chrishonson/openBMS/Docs/System-general-connections.pdf

# OpenBMS connection with CAN

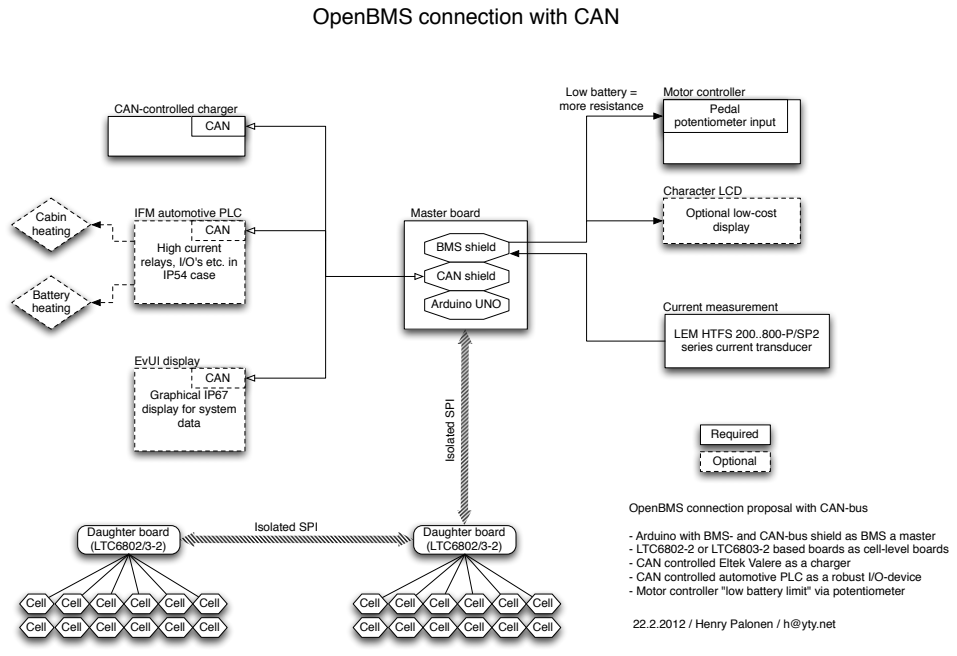
[picture p1: page 1]
Cell; Cell Cell Cell Cell Cell; Daughter board (LTC6802/3-2); BMS shield; CAN shield; Arduino UNO; CAN; Cabin heating; Battery heating; Motor controller Pedal potentiometer input; Current measurement; data; EvUI display; Character LCD; Required; Optional

Low battery =
more resistance
Master board Isolated SPI

CAN-controlled charger

IFM automotive PLC

Optional low-cost
display

High current
relays, I/O's etc. in
IP54 case

LEM HTFS 200..800-P/SP2
series current transducer

Graphical IP67
display for system

OpenBMS connection proposal with CAN-bus

Isolated SPI Daughter board
(LTC6802/3-2)

- Arduino with BMS- and CAN-bus shield as BMS a master
- LTC6802-2 or LTC6803-2 based boards as cell-level boards
- CAN controlled Eltek Valere as a charger
- CAN controlled automotive PLC as a robust I/O-device
- Motor controller "low battery limit" via potentiometer

22.2.2012 / Henry Palonen / h@yty.net
