chrishonson/openBMS/PCB_Design/daughter_board/bms3_1.brd

## EAGLE design PCB_Design/daughter_board/bms3_1.brd (2012-10-20)

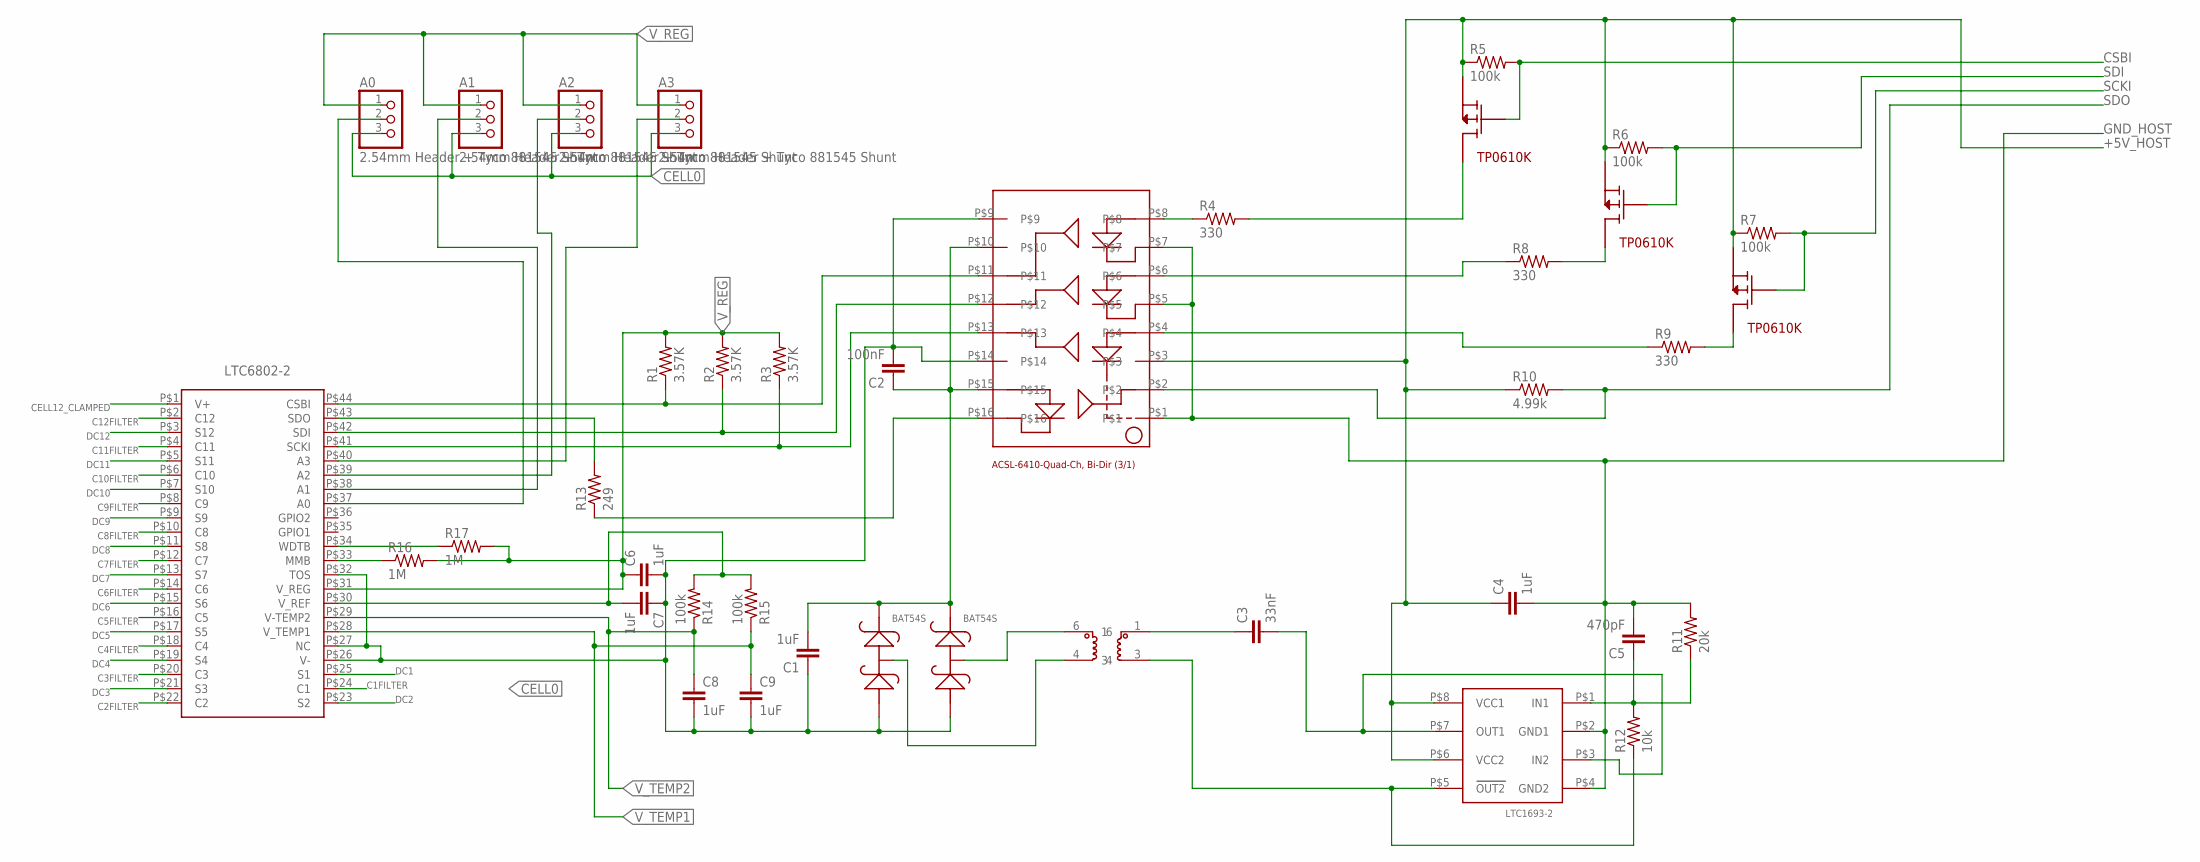
[picture p2: schematic bms3_1.sch, sheet 1]

Parts:
A0, A1, A2, A3: 2.54mm Header + Tyco 881545 Shunt; 1X03
ACSL6410: ACSL-6410; ACSL-6410-SO16
BAT1, BAT2: BAT54S; SOT-23
C1, C4, C6, C7, C8, C9: 1uF; C0603
C2: 100nF; C0603
C3: 33nF; C0603
C5: 470pF; C0603
CSBI: TP0610K; SOT-23
LTC1693: LTC1693-2; S8-LTC1693-2
PE68386: PE68386
R1, R2, R3: 3.57K; R0603
R4, R8, R9: 330; R0603
R5, R6, R7, R14, R15: 100k; R0603
R10: 4.99k; R0603
R11: 20k; R0603
R12: 10k; R0603
R13: 249; R0603
R16, R17: 1M; R0603
SCKI: TP0610K; SOT-23
SDI: TP0610K; SOT-23
X-BMS: LTC6802-2; SSOP-44

Connections:
+5V_HOST: ACSL6410.P$3, C4.1, CSBI.2, LTC1693.P$6 (VCC2), LTC1693.P$8 (VCC1), R5.1, R6.1, R7.1, R10.1, SCKI.2, SDI.2; also elsewhere on the board
C1FILTER: X-BMS.P$24 (C1); also elsewhere on the board
C2FILTER: X-BMS.P$22 (C2); also elsewhere on the board
C3FILTER: X-BMS.P$20 (C3); also elsewhere on the board
C4FILTER: X-BMS.P$18 (C4); also elsewhere on the board
C5FILTER: X-BMS.P$16 (C5); also elsewhere on the board
C6FILTER: X-BMS.P$14 (C6); also elsewhere on the board
C7FILTER: X-BMS.P$12 (C7); also elsewhere on the board
C8FILTER: X-BMS.P$10 (C8); also elsewhere on the board
C9FILTER: X-BMS.P$8 (C9); also elsewhere on the board
C10FILTER: X-BMS.P$6 (C10); also elsewhere on the board
C11FILTER: X-BMS.P$4 (C11); also elsewhere on the board
C12FILTER: X-BMS.P$2 (C12); also elsewhere on the board
CELL0: A0.3, A1.3, A2.3, A3.3, ACSL6410.P$9, ACSL6410.P$14, BAT1.1, BAT2.1, C1.1, C2.2, C6.2, C7.1, C8.2, C9.2, X-BMS.P$26 (V-), X-BMS.P$27 (NC), X-BMS.P$32 (TOS); also elsewhere on the board
CELL12_CLAMPED: X-BMS.P$1 (V+); also elsewhere on the board
CSBI: CSBI.1, R5.2; also elsewhere on the board
DC1: X-BMS.P$25 (S1); also elsewhere on the board
DC2: X-BMS.P$23 (S2); also elsewhere on the board
DC3: X-BMS.P$21 (S3); also elsewhere on the board
DC4: X-BMS.P$19 (S4); also elsewhere on the board
DC5: X-BMS.P$17 (S5); also elsewhere on the board
DC6: X-BMS.P$15 (S6); also elsewhere on the board
DC7: X-BMS.P$13 (S7); also elsewhere on the board
DC8: X-BMS.P$11 (S8); also elsewhere on the board
DC9: X-BMS.P$9 (S9); also elsewhere on the board
DC10: X-BMS.P$7 (S10); also elsewhere on the board
DC11: X-BMS.P$5 (S11); also elsewhere on the board
DC12: X-BMS.P$3 (S12); also elsewhere on the board
GND_HOST: ACSL6410.P$1, ACSL6410.P$5, ACSL6410.P$7, C4.2, C5.2, LTC1693.P$2 (GND1), LTC1693.P$4 (GND2), R11.2; also elsewhere on the board
unnamed: ACSL6410.P$11, R1.1, X-BMS.P$44 (CSBI)
unnamed: A3.2, X-BMS.P$40 (A3)
unnamed: ACSL6410.P$12, R2.1, X-BMS.P$42 (SDI)
unnamed: ACSL6410.P$13, R3.1, X-BMS.P$41 (SCKI)
unnamed: A2.2, X-BMS.P$39 (A2)
unnamed: A1.2, X-BMS.P$38 (A1)
unnamed: ACSL6410.P$16, R13.1
unnamed: R13.2, X-BMS.P$43 (SDO)
unnamed: BAT2.3, PE68386.6
unnamed: BAT1.3, PE68386.4
unnamed: R8.2, SDI.3
unnamed: C3.1, PE68386.1
unnamed: LTC1693.P$5 (OUT2), PE68386.3, R12.1
unnamed: C3.2, LTC1693.P$3 (IN2), LTC1693.P$7 (OUT1)
unnamed: A0.2, X-BMS.P$37 (A0)
unnamed: ACSL6410.P$6, R8.1
unnamed: C5.1, LTC1693.P$1 (IN1), R11.1, R12.2
unnamed: R9.2, SCKI.3
unnamed: ACSL6410.P$4, R9.1
unnamed: R17.1, X-BMS.P$34 (WDTB)
unnamed: R16.1, X-BMS.P$33 (MMB)
unnamed: ACSL6410.P$8, R4.1
unnamed: CSBI.3, R4.2
unnamed: ACSL6410.P$10, ACSL6410.P$15, BAT1.2, BAT2.2, C1.2, C2.1
SCKI: R7.2, SCKI.1; also elsewhere on the board
SDI: R6.2, SDI.1; also elsewhere on the board
SDO: ACSL6410.P$2, R10.2; also elsewhere on the board
V_REF: C7.2, R14.2, R15.2, X-BMS.P$30 (V_REF)
V_REG: A0.1, A1.1, A2.1, A3.1, C6.1, R1.2, R2.2, R3.2, R16.2, R17.2, X-BMS.P$31 (V_REG)
V_TEMP1: C9.1, R15.1, X-BMS.P$28 (V_TEMP1); also elsewhere on the board
V_TEMP2: C8.1, R14.1, X-BMS.P$29 (V-TEMP2); also elsewhere on the board

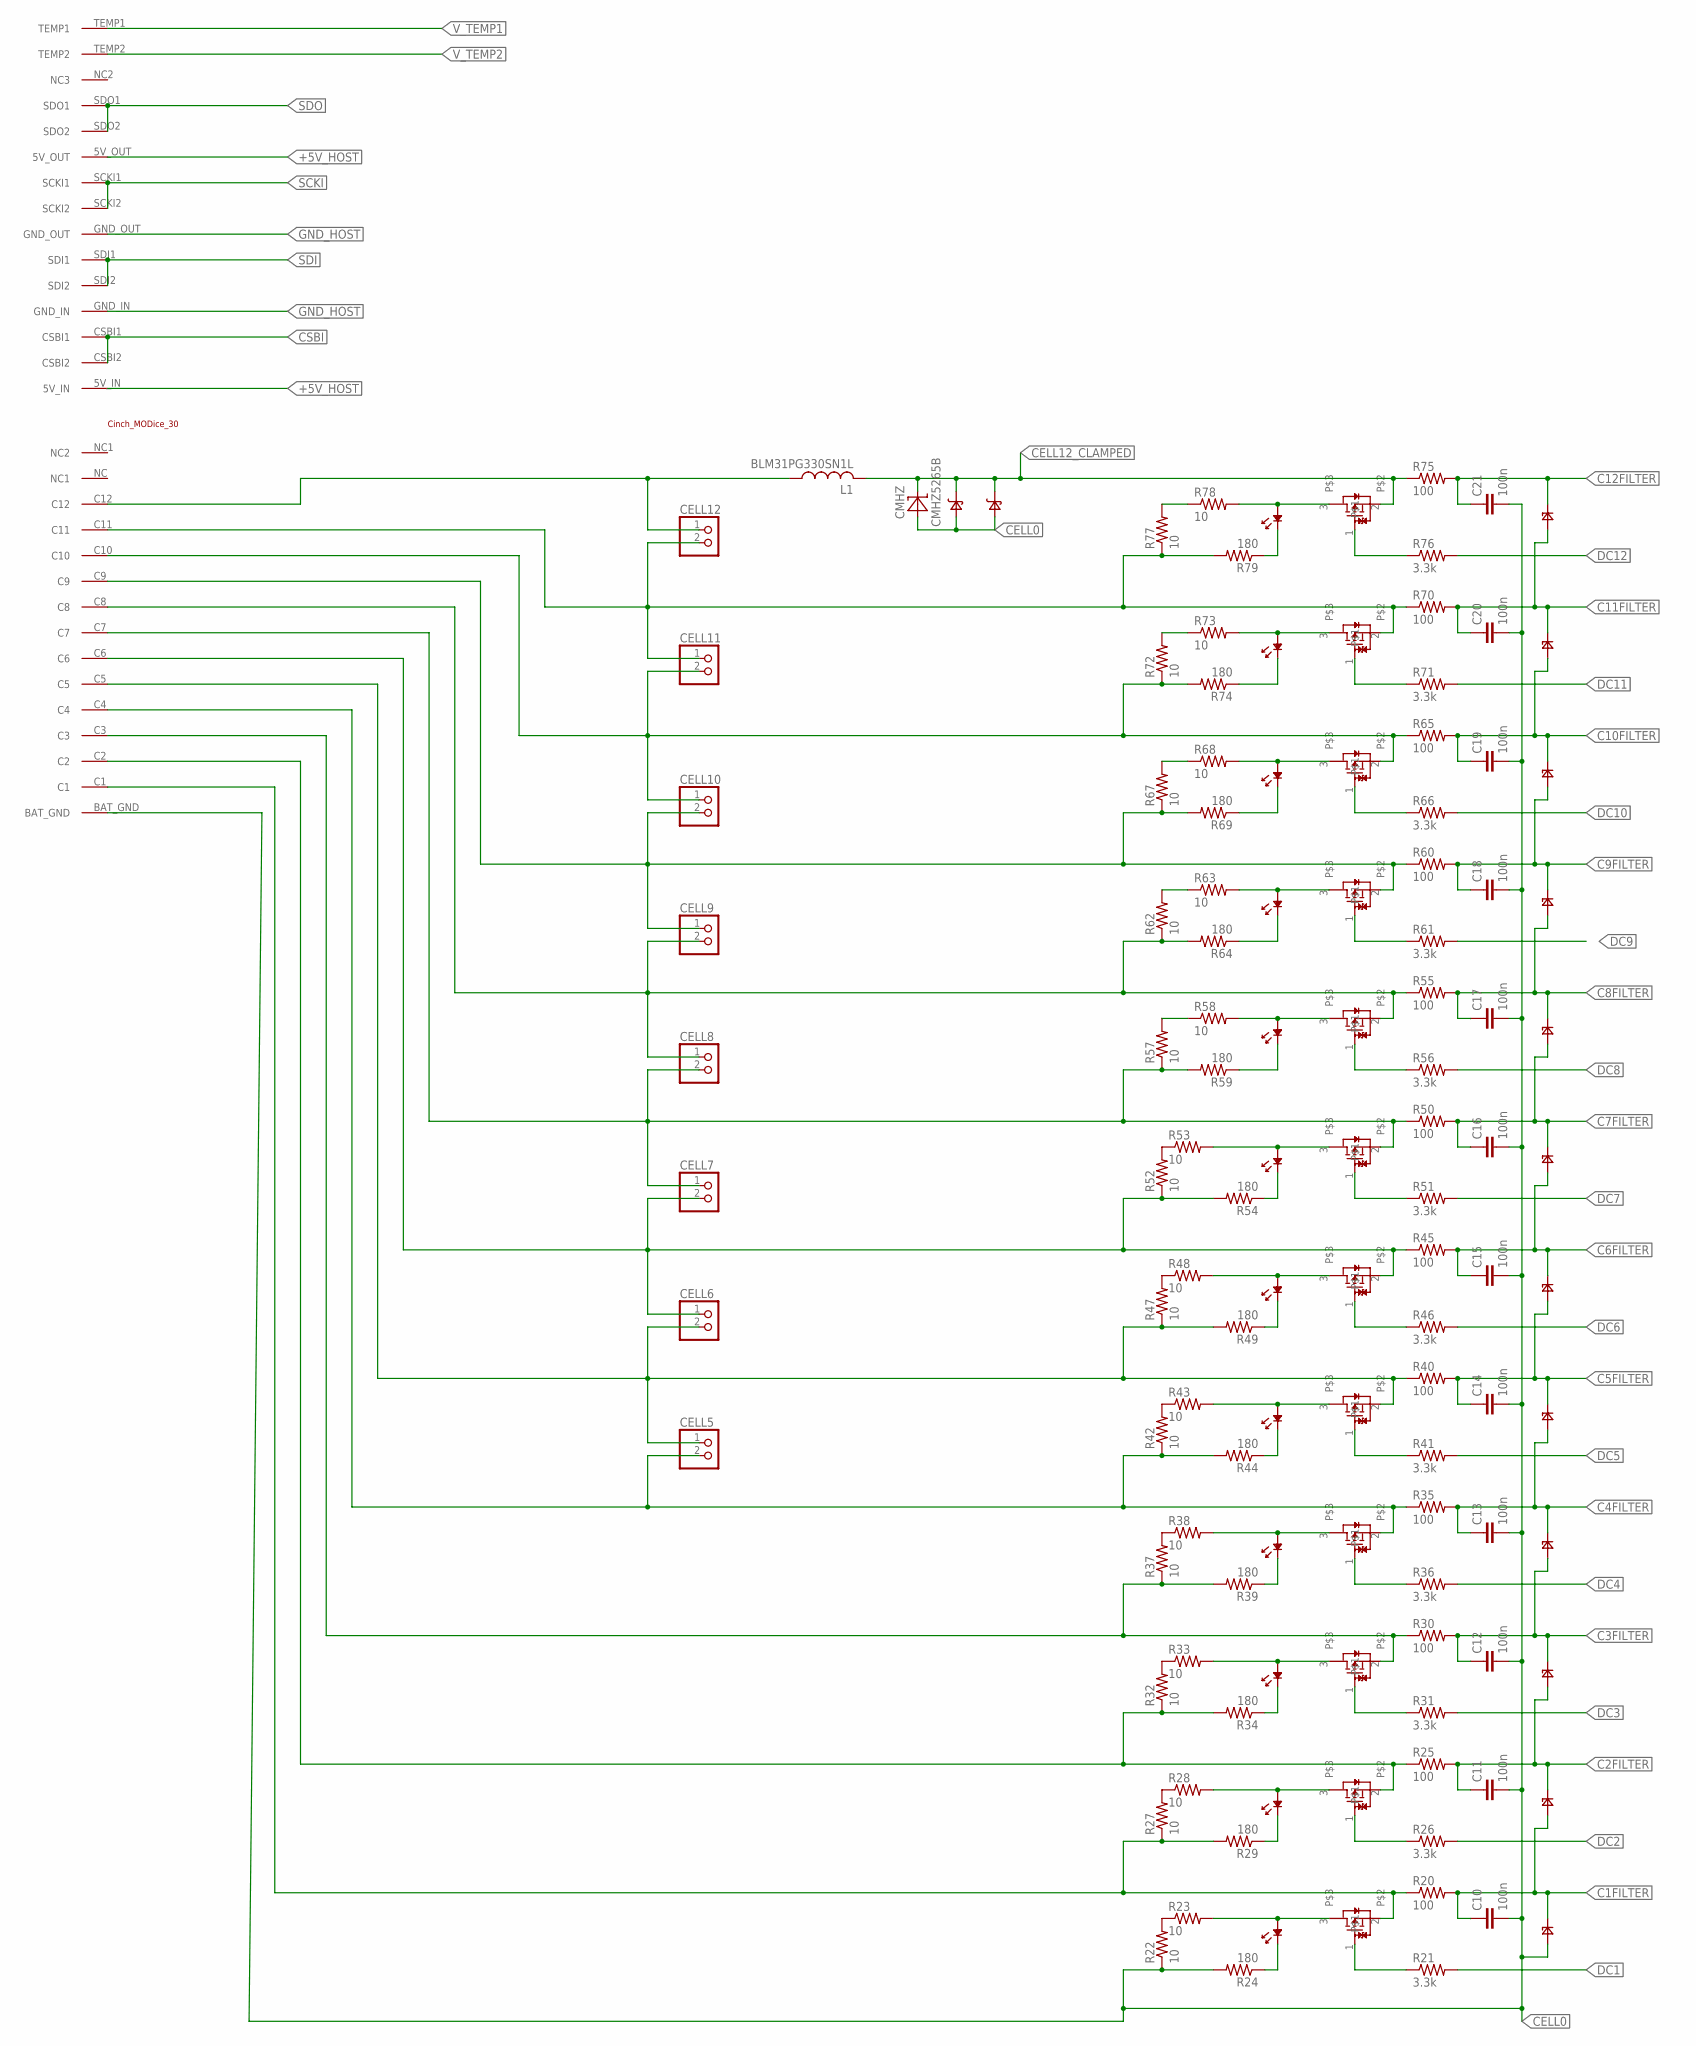
[picture p3: schematic bms3_1.sch, sheet 2]

Parts:
BAT3, BAT4: BAT46W; SOD123
C10, C11, C12, C13, C14, C15, C16, C17, C18, C19, C20, C21: 100n; C0603
CELL5, CELL6, CELL7, CELL8, CELL9, CELL10, CELL11, CELL12: PINHD-1X2; 1X02
CMHZ: CMHZ5265B; SOD123
L1: BLM31PG330SN1L; L3216C
LED1, LED2, LED3, LED4, LED5, LED6, LED7, LED8, LED9, LED10, LED11, LED12: LED-0805; 0805
MODICE: MODICE_30; CINCH_HEADER30
PD1, PD2, PD3, PD4, PD5, PD6, PD7, PD8, PD9, PD10, PD11, PD12: PDZ7.5B; SOD323
R20, R25, R30, R35, R40, R45, R50, R55, R60, R65, R70, R75: 100; R0603
R21, R26, R31, R36, R41, R46, R51, R56, R61, R66, R71, R76: 3.3k; R0603
R22, R23, R27, R28, R32, R33, R37, R38, R42, R43, R47, R48, R52, R53, R57, R58, R62, R63, R67, R68, R72, R73, R77, R78: 10; R2512
R24, R29, R34, R39, R44, R49, R54, R59, R64, R69, R74, R79: 180; R0805
T1, T2, T3, T4, T5, T6, T7, T8, T9, T10, T11, T12: RTR020P02; TSMT3

Connections:
+5V_HOST: MODICE.5V_IN, MODICE.5V_OUT; also elsewhere on the board
C1FILTER: C10.1, PD1.P$1, PD2.P$2, R20.2; also elsewhere on the board
C2FILTER: C11.1, PD2.P$1, PD3.P$2, R25.2; also elsewhere on the board
C3FILTER: C12.1, PD3.P$1, PD4.P$2, R30.2; also elsewhere on the board
C4FILTER: C13.1, PD4.P$1, PD5.P$2, R35.2; also elsewhere on the board
C5FILTER: C14.1, PD5.P$1, PD6.P$2, R40.2; also elsewhere on the board
C6FILTER: C15.1, PD6.P$1, PD7.P$2, R45.2; also elsewhere on the board
C7FILTER: C16.1, PD7.P$1, PD8.P$2, R50.2; also elsewhere on the board
C8FILTER: C17.1, PD8.P$1, PD9.P$2, R55.2; also elsewhere on the board
C9FILTER: C18.1, PD9.P$1, PD10.P$2, R60.2; also elsewhere on the board
C10FILTER: C19.1, PD10.P$1, PD11.P$2, R65.2; also elsewhere on the board
C11FILTER: C20.1, PD11.P$1, PD12.P$2, R70.2; also elsewhere on the board
C12FILTER: C21.1, PD12.P$1, R75.2; also elsewhere on the board
CELL0: BAT3.POS, BAT4.POS, C10.2, C11.2, C12.2, C13.2, C14.2, C15.2, C16.2, C17.2, C18.2, C19.2, C20.2, C21.2, CMHZ.POS (A), MODICE.BAT_GND, PD1.P$2, R22.1, R24.2; also elsewhere on the board
CELL1: MODICE.C1, R20.1, R27.1, R29.2, T1.2
CELL2: MODICE.C2, R25.1, R32.1, R34.2, T2.2
CELL3: MODICE.C3, R30.1, R37.1, R39.2, T3.2
CELL4: CELL5.2, MODICE.C4, R35.1, R42.1, R44.2, T4.2
CELL5: CELL5.1, CELL6.2, MODICE.C5, R40.1, R47.1, R49.2, T5.2
CELL6: CELL6.1, CELL7.2, MODICE.C6, R45.1, R52.1, R54.2, T6.2
CELL7: CELL7.1, CELL8.2, MODICE.C7, R50.1, R57.1, R59.2, T7.2
CELL8: CELL8.1, CELL9.2, MODICE.C8, R55.1, R62.1, R64.2, T8.2
CELL9: CELL9.1, CELL10.2, MODICE.C9, R60.1, R67.1, R69.2, T9.2
CELL10: CELL10.1, CELL11.2, MODICE.C10, R65.1, R72.1, R74.2, T10.2
CELL11: CELL11.1, CELL12.2, MODICE.C11, R70.1, R77.1, R79.2, T11.2
CELL12: CELL12.1, L1.1, MODICE.C12
CELL12_CLAMPED: BAT3.NEG, BAT4.NEG, CMHZ.NEG (C), L1.2, R75.1, T12.2; also elsewhere on the board
CSBI: MODICE.CSBI1, MODICE.CSBI2; also elsewhere on the board
DC1: R21.2; also elsewhere on the board
DC2: R26.2; also elsewhere on the board
DC3: R31.2; also elsewhere on the board
DC4: R36.2; also elsewhere on the board
DC5: R41.2; also elsewhere on the board
DC6: R46.2; also elsewhere on the board
DC7: R51.2; also elsewhere on the board
DC8: R56.2; also elsewhere on the board
DC9: R61.2; also elsewhere on the board
DC10: R66.2; also elsewhere on the board
DC11: R71.2; also elsewhere on the board
DC12: R76.2; also elsewhere on the board
GND_HOST: MODICE.GND_IN, MODICE.GND_OUT; also elsewhere on the board
LED3: LED3.P$1, R34.1
unnamed: R77.2, R78.1
unnamed: LED1.P$2, R23.2, T1.3
unnamed: LED1.P$1, R24.1
unnamed: LED2.P$2, R28.2, T2.3
unnamed: R21.1, T1.1
unnamed: R72.2, R73.1
unnamed: R67.2, R68.1
unnamed: LED2.P$1, R29.1
unnamed: R26.1, T2.1
unnamed: R62.2, R63.1
unnamed: LED9.P$2, R63.2, T9.3
unnamed: R57.2, R58.1
unnamed: LED3.P$2, R33.2, T3.3
unnamed: R52.2, R53.1
unnamed: R31.1, T3.1
unnamed: R47.2, R48.1
unnamed: LED4.P$2, R38.2, T4.3
unnamed: LED4.P$1, R39.1
unnamed: R42.2, R43.1
unnamed: R37.2, R38.1
unnamed: LED9.P$1, R64.1
unnamed: R32.2, R33.1
unnamed: LED5.P$2, R43.2, T5.3
unnamed: LED5.P$1, R44.1
unnamed: R41.1, T5.1
unnamed: R27.2, R28.1
unnamed: LED6.P$2, R48.2, T6.3
unnamed: LED6.P$1, R49.1
unnamed: R46.1, T6.1
unnamed: R22.2, R23.1
unnamed: R61.1, T9.1
unnamed: LED7.P$2, R53.2, T7.3
unnamed: LED7.P$1, R54.1
unnamed: R51.1, T7.1
unnamed: LED8.P$2, R58.2, T8.3
unnamed: LED8.P$1, R59.1
unnamed: R56.1, T8.1
unnamed: LED10.P$2, R68.2, T10.3
unnamed: LED10.P$1, R69.1
unnamed: R66.1, T10.1
unnamed: LED11.P$2, R73.2, T11.3
unnamed: LED11.P$1, R74.1
unnamed: R71.1, T11.1
unnamed: LED12.P$2, R78.2, T12.3
unnamed: LED12.P$1, R79.1
unnamed: R76.1, T12.1
SCKI: MODICE.SCKI1, MODICE.SCKI2; also elsewhere on the board
SDI: MODICE.SDI1, MODICE.SDI2; also elsewhere on the board
SDO: MODICE.SDO1, MODICE.SDO2; also elsewhere on the board
T4: R36.1, T4.1
V_TEMP1: MODICE.TEMP1; also elsewhere on the board
V_TEMP2: MODICE.TEMP2; also elsewhere on the board

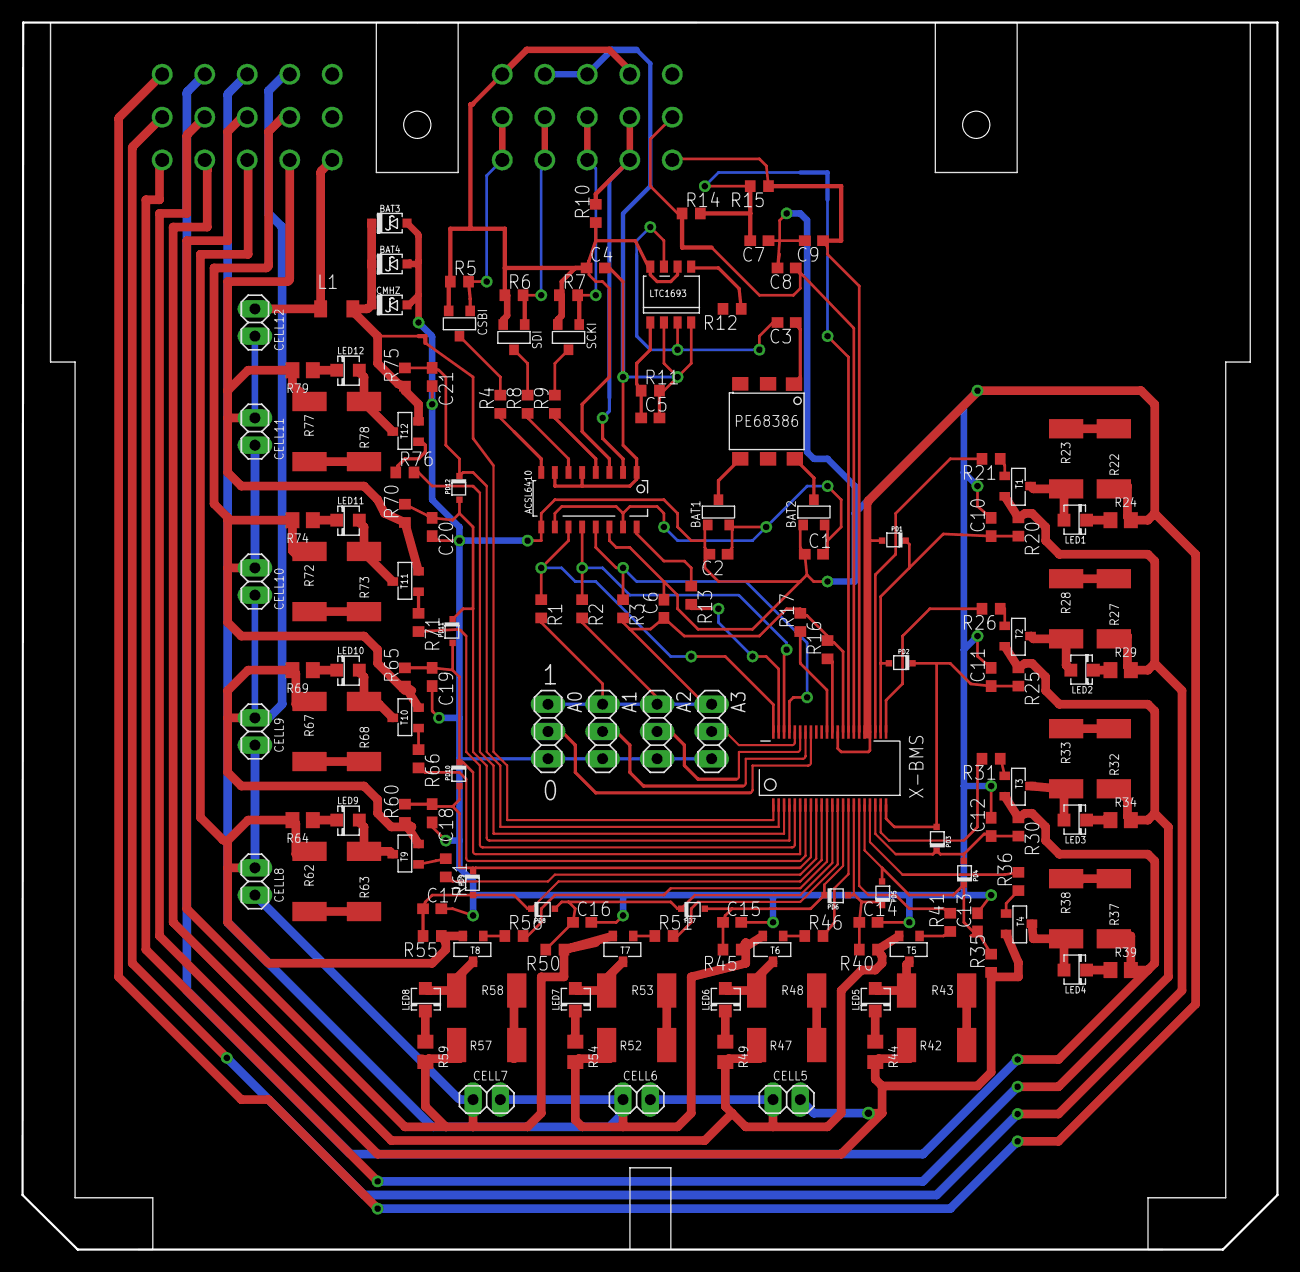
[picture p4: board bms3_1.brd from above]

Board: 2 copper layers, 116.9 x 114.3 mm, 160 parts (0 on the bottom side), 120 nets.
