chrishonson/openBMS/(commit log)

2012-02-22 Master Shield first commits
    [OpenBMS_Master_Shield.brd, OpenBMS_Master_Shield.sch, bms3.brd, bms3.sch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]
2012-02-22 Proposal for connection with CAN-bus
2012-02-24 * Removed spaces from directory names so that Eagle can find them directly
    New schema for OpenBMS Master card:
    + 3 x optically isolated SSR's (max 60V / 4A each)
    [OpenBMS_Master_Shield.brd, OpenBMS_Master_Shield.sch, bms3.brd, bms3.sch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]
2012-03-04 Preparing for BatchPCB test-run
    [OpenBMS_Master_Shield.brd, OpenBMS_Master_Shield.sch]
2012-10-20 replacing 0402 with 0603
    [bms3_1.brd, bms3_1.sch]
2012-10-20 more 0603
    [bms3_1.brd, bms3_1.sch]
